LOGDrakon/Aurora/Docs/DT-AURORA-MEM-001.docx

# Document Technique Aurora — Structure Mémoire Flash

## DT-AURORA-MEM-001 — Révision B

Projet : Aurora — Verrine LED Industrielle Intelligente
Objet : Définition de la structure de données en mémoire Flash
Plateforme : STM32G0B1 — Flash interne
Date : 2025-01-15
Statut : Draft

## Table des matières

1. Introduction (https://mammouth.ai/app/a/130160/c/9894304)
2. Principes de conception (https://mammouth.ai/app/a/130160/c/9894304)
3. Cartographie mémoire (https://mammouth.ai/app/a/130160/c/9894304)
4. Header de configuration (https://mammouth.ai/app/a/130160/c/9894304)
5. Structure TLV générique (https://mammouth.ai/app/a/130160/c/9894304)
6. Bloc LEDS — 0x01 (https://mammouth.ai/app/a/130160/c/9894304)
7. Bloc SCÈNES — 0x02 (https://mammouth.ai/app/a/130160/c/9894304)
8. Bloc ENTRÉES — 0x03 (https://mammouth.ai/app/a/130160/c/9894304)
9. Bloc SYSTÈME — 0x04 (https://mammouth.ai/app/a/130160/c/9894304)
10. Bilan mémoire (https://mammouth.ai/app/a/130160/c/9894304)
11. Parser firmware (https://mammouth.ai/app/a/130160/c/9894304)
12. Intégrité et écriture Flash (https://mammouth.ai/app/a/130160/c/9894304)
13. Évolutivité (https://mammouth.ai/app/a/130160/c/9894304)
14. Annexes (https://mammouth.ai/app/a/130160/c/9894304)

## 1. Introduction

### 1.1 Objectif du document

Ce document définit le format binaire utilisé pour stocker la configuration complète d'un module Aurora en mémoire Flash interne du STM32G0B1. Cette structure est lue au démarrage par le firmware, modifiable via le bus de communication LINK, et éditable via l'application PC Aurora-LINK.

### 1.2 Périmètre

La configuration couvre :

- La définition matérielle de la sortie LED (2 LEDs pilotées en tandem)
- Les scènes d'éclairage prédéfinies (jusqu'à 16)
- Les patterns d'animation personnalisés (jusqu'à 8)
- Le mapping des entrées logiques (10 entrées)
- Les paramètres système (démarrage, diagnostics)

### 1.3 Hypothèse fondamentale

Les deux LEDs du module Aurora fonctionnent toujours ensemble, de manière synchrone. Il n'existe aucun mode permettant de les piloter indépendamment. Toute la configuration décrit donc un unique canal lumineux alimentant les deux LEDs simultanément.

### 1.4 Contraintes

Contrainte | Valeur
Taille page Flash STM32G0B1 | 2048 bytes
Endianness | Little-endian
Alignement | Structures packées (__attribute__((packed)))
Allocation dynamique | Interdite
Durée de vie Flash | 10 000 cycles d'écriture

## 2. Principes de conception

### 2.1 Format TLV (Type-Length-Value)

Toute la zone de données est organisée en blocs TLV contigus. Chaque bloc possède un identifiant de type, une longueur de payload, et les données associées. Ce format permet :

- Le parsing séquentiel sans table d'index
- L'ignorance des blocs inconnus pour la compatibilité ascendante
- L'ajout de nouveaux blocs sans modifier le parser existant

### 2.2 Pas d'allocation dynamique

Le parser lit la Flash en place (mapping direct par pointeurs). Les structures de travail en RAM sont de taille fixe, dimensionnées pour les maximums définis dans ce document.

### 2.3 Intégrité

Un CRC32 en fin de page garantit la validité de l'ensemble. Si le CRC est invalide ou le magic absent, le firmware démarre en mode par défaut.

## 3. Cartographie mémoire

Adresse | Contenu | Taille
0x000 0x010 0x7FC | Header de configuration Bloc LEDS (TLV) Bloc SCÈNES (TLV) Bloc ENTRÉES (TLV) Bloc SYSTÈME (TLV) … Padding (0xFF) CRC32 | 16 bytes variable variable variable variable variable 4 bytes
| TOTAL PAGE | 2048 bytes

Les blocs TLV se succèdent sans espacement. L'espace restant entre le dernier bloc et le CRC32 est rempli de 0xFF (état natif de la Flash effacée).

## 4. Header de configuration

### 4.1 Structure

typedef struct __attribute__((packed)) {

uint32_t magic; // Identifiant fixe

uint8_t version; // Version du format

uint8_t num_blocs; // Nombre de blocs TLV présents

uint16_t total_len; // Taille totale des données TLV (bytes)

uint32_t write_count; // Compteur d'écritures

uint32_t reserved; // Réservé (0xFFFFFFFF)

} aurora_header_t;

### 4.2 Détail des champs

Champ | Offset | Taille | Valeur | Description
magic | 0x00 | 4 | 0x41555241 | Signature ASCII "AURA"
version | 0x04 | 1 | 0x01 | Version du format de structure
num_blocs | 0x05 | 1 | 1–255 | Nombre de blocs TLV dans la page
total_len | 0x06 | 2 | 0–2028 | Taille cumulée de tous les blocs TLV
write_count | 0x08 | 4 | 0–n | Incrémenté à chaque écriture
reserved | 0x0C | 4 | 0xFFFFFFFF | Réservé pour usage futur

### 4.3 Taille

16 bytes fixes.

## 5. Structure TLV générique

### 5.1 En-tête de bloc

typedef struct __attribute__((packed)) {

uint8_t type; // Identifiant du bloc

uint8_t flags; // Drapeaux (réservé, mis à 0x00)

uint16_t length; // Taille du payload en bytes

uint8_t data[]; // Payload (flexible array member)

} aurora_bloc_t;

### 5.2 Table des types

Type ID | Nom | Description | Requis
0x01 | BLOC_LEDS | Configuration matérielle de la sortie LED | Oui
0x02 | BLOC_SCENES | Définition des scènes et patterns | Oui
0x03 | BLOC_INPUTS | Mapping des entrées logiques | Oui
0x04 | BLOC_SYSTEM | Paramètres système | Oui
0x05–0xEF | — | Réservés pour extensions futures | —
0xF0–0xFF | — | Réservés pour usage constructeur | —

### 5.3 Taille de l'en-tête TLV

4 bytes fixes + payload variable.

### 5.4 Règle de parsing

Le parser avance de sizeof(aurora_bloc_t) + bloc->length bytes à chaque itération. Un bloc de type inconnu est ignoré silencieusement (skip par la longueur).

## 6. Bloc LEDS — 0x01

### 6.1 Description

Ce bloc définit la configuration matérielle du canal LED unique. Les deux LEDs physiques sont pilotées de manière identique et synchrone. Ce bloc ne décrit pas l'état lumineux (c'est le rôle des scènes) mais les limites physiques du canal.

### 6.2 Structure

typedef struct __attribute__((packed)) {

uint8_t max_pwm; // Limitation PWM max (0–255 → 0–100%)

uint16_t soft_start_ms; // Durée de la rampe de démarrage

uint8_t reserved; // Réservé (0xFF)

} aurora_led_cfg_t;

### 6.3 Détail des champs

Champ | Taille | Plage | Description
max_pwm | 1 | 0–255 | Plafond PWM appliqué aux deux LEDs (protection thermique / optique)
soft_start_ms | 2 | 0–65535 | Rampe progressive au démarrage en ms
reserved | 1 | 0xFF | Réservé

### 6.4 Taille du bloc

- En-tête TLV : 4 bytes
- Payload : 4 bytes
- Total : 8 bytes

## 7. Bloc SCÈNES — 0x02

### 7.1 Description

Une scène est un état complet et statique du canal lumineux (les deux LEDs simultanément). Le module supporte jusqu'à 16 scènes. Une scène est activée soit par une entrée logique, soit par commande LINK, soit automatiquement au démarrage.

### 7.2 Structure d'état LED

typedef struct __attribute__((packed)) {

uint8_t mode; // Mode d'animation

uint8_t brightness; // Luminosité cible (0–255)

uint16_t t_on_ms; // Durée de la phase ON

uint16_t t_off_ms; // Durée de la phase OFF

uint8_t repeat; // Nombre de répétitions (0 = infini)

uint8_t fade_time; // Temps de fondu (unité : 10ms, 0 = instantané)

} aurora_led_state_t;

### 7.3 Modes LED

typedef enum {

LED_MODE_OFF = 0x00, // LEDs éteintes

LED_MODE_STATIC = 0x01, // Allumage fixe

LED_MODE_BLINK = 0x02, // Clignotement ON/OFF

LED_MODE_FADE = 0x03, // Respiration (fondu entrant/sortant)

LED_MODE_BURST = 0x04, // N flashs rapides + pause

LED_MODE_DOUBLE = 0x05, // Double flash aéronautique

LED_MODE_PATTERN = 0x06, // Pattern personnalisé

} aurora_led_mode_t;

### 7.4 Détail des modes

Mode | brightness | t_on_ms | t_off_ms | repeat | fade_time
OFF | ignoré | ignoré | ignoré | ignoré | ignoré
STATIC | niveau fixe | ignoré | ignoré | ignoré | rampe allumage
BLINK | niveau ON | durée ON | durée OFF | 0 = infini | transition
FADE | niveau max | durée montée | durée descente | 0 = infini | ignoré (implicite)
BURST | niveau flash | durée flash | pause entre bursts | nb flashs par burst | ignoré
DOUBLE | niveau flash | durée flash | pause inter-flash | ignoré (toujours 2) | pause post-double
PATTERN | ignoré | ignoré | ignoré | ignoré | index pattern

### 7.5 Structure de scène

typedef struct __attribute__((packed)) {

uint8_t scene_id; // Identifiant : 0x00–0x0F

uint8_t flags; // Drapeaux

aurora_led_state_t state; // État du canal lumineux

} aurora_scene_t;

### 7.6 Drapeaux de scène

Bit | Nom | Description
0 | SCENE_FLAG_AUTOSTART | Charger cette scène automatiquement au démarrage
1–7 | — | Réservés (mis à 0)

### 7.7 Patterns personnalisés

Lorsqu'un état LED utilise LED_MODE_PATTERN, le champ fade_time contient l'index d'un pattern stocké à la suite des scènes dans le même bloc.

typedef struct __attribute__((packed)) {

uint8_t brightness; // Niveau de luminosité cible

uint8_t duration; // Durée de ce pas (unité : 10ms, max 2.55s)

} aurora_pattern_step_t;

typedef struct __attribute__((packed)) {

uint8_t pattern_id; // Identifiant : 0x00–0x07

uint8_t length; // Nombre de pas (max 16)

aurora_pattern_step_t steps[]; // Tableau de pas

} aurora_pattern_t;

### 7.8 Organisation interne du bloc SCÈNES

### En-tête TLV (4 bytes)

aurora_scene_t #0 (10 B)

aurora_scene_t #1 (10 B)

aurora_scene_t #15 (10 B)

aurora_pattern_t #0

aurora_pattern_t #1

aurora_pattern_t #7

### 7.9 Exemple concret — scène alarme

Canal lumineux : clignotement à 100%, 200ms ON / 800ms OFF, infini

Octets (hex) :

Scène : 00 00 → scene_id=0, flags=0

État : 02 FF 00C8 0320 00 00 → BLINK, 255, 200ms, 800ms, infini, pas de fondu

### 7.10 Taille du bloc

- En-tête TLV : 4 bytes
- Scènes : 16 × 10 = 160 bytes
- Patterns : 8 × (2 + 16 × 2) = 272 bytes
- Total max : 436 bytes

Seules les scènes et patterns effectivement utilisés doivent être stockés. Le nombre est déterminé dynamiquement par la longueur du bloc.

## 8. Bloc ENTRÉES — 0x03

### 8.1 Description

Chaque entrée logique (10 entrées disponibles) est associée à une règle composée d'un déclencheur (trigger) et d'une action.

### 8.2 Structure

typedef struct __attribute__((packed)) {

uint8_t input_id; // Index d'entrée : 0–9

uint8_t trigger; // Type de déclencheur

uint8_t action; // Action à exécuter

uint8_t target; // Cible de l'action (scene_id, etc.)

uint16_t param; // Paramètre contextuel

uint16_t debounce_ms; // Durée d'anti-rebond

} aurora_input_cfg_t;

### 8.3 Déclencheurs

typedef enum {

TRIG_RISING = 0x00, // Front montant

TRIG_FALLING = 0x01, // Front descendant

TRIG_HIGH = 0x02, // Niveau haut maintenu

TRIG_LOW = 0x03, // Niveau bas maintenu

TRIG_DOUBLE_TAP = 0x04, // Double impulsion (param = fenêtre ms)

TRIG_LONG_PRESS = 0x05, // Appui long (param = seuil ms)

TRIG_PULSE = 0x06, // Impulsion calibrée (param = durée attendue ms)

} aurora_trigger_t;

### 8.4 Actions

typedef enum {

ACT_LOAD_SCENE = 0x00, // Charger scène (target = scene_id)

ACT_SET_BRIGHT = 0x01, // Fixer luminosité (param.lo = brightness)

ACT_TOGGLE = 0x02, // Basculer ON/OFF

ACT_ALL_OFF = 0x03, // Tout éteindre

ACT_DIM_UP = 0x04, // Augmenter luminosité (param = pas)

ACT_DIM_DOWN = 0x05, // Diminuer luminosité (param = pas)

ACT_LOCK = 0x06, // Verrouiller toutes les autres entrées

ACT_UNLOCK = 0x07, // Déverrouiller les entrées

ACT_IDENTIFY = 0x08, // Lancer la séquence d'identification visuelle

} aurora_action_t;

### 8.5 Matrice trigger × action — exemples

Cas d'usage | Entrée | Trigger | Action | Target | Param
Alarme incendie | E0 | TRIG_HIGH | ACT_LOAD_SCENE | 1 | —
Bouton poussoir | E1 | TRIG_RISING | ACT_TOGGLE | — | —
Variateur + | E2 | TRIG_RISING | ACT_DIM_UP | — | 25
Appui long reset | E3 | TRIG_LONG_PRESS | ACT_ALL_OFF | — | 3000
Double tap ident | E4 | TRIG_DOUBLE_TAP | ACT_IDENTIFY | — | 500

### 8.6 Anti-rebond

Le champ debounce_ms définit la durée minimale pendant laquelle l'entrée doit rester stable avant validation du changement d'état. Plage recommandée : 10–50ms pour boutons mécaniques, 1–5ms pour signaux logiques propres.

### 8.7 Taille du bloc

- En-tête TLV : 4 bytes
- Entrées : 10 × 8 = 80 bytes
- Total : 84 bytes

## 9. Bloc SYSTÈME — 0x04

### 9.1 Description

Paramètres globaux du module : comportement au démarrage et diagnostics.

### 9.2 Structure

typedef struct __attribute__((packed)) {

uint8_t boot_scene; // Scène chargée au démarrage (0xFF = aucune)

uint8_t temp_derating; // Seuil de derating thermique (°C, 0 = désactivé)

uint16_t hours_counter; // Compteur horaire cumulé (heures)

uint32_t reserved; // Réservé (0xFFFFFFFF)

} aurora_system_cfg_t;

### 9.3 Détail des champs

Champ | Taille | Plage | Description
boot_scene | 1 | 0x00–0x0F, 0xFF | Scène auto au power-on. 0xFF = pas de scène auto
temp_derating | 1 | 0–150 | Température en °C au-delà de laquelle le firmware réduit la puissance. 0 = fonction désactivée
hours_counter | 2 | 0–65535 | Compteur horaire incrémenté par le firmware. Sauvegardé périodiquement
reserved | 4 | 0xFFFFFFFF | Réservé pour usage futur

### 9.4 Taille du bloc

- En-tête TLV : 4 bytes
- Payload : 8 bytes
- Total : 12 bytes

## 10. Bilan mémoire

### 10.1 Synthèse

Élément | Taille | Remarque
Header | 16 bytes | Fixe
Bloc LEDS | 8 bytes | Canal unique
Bloc SCÈNES | 436 bytes max | 16 scènes + 8 patterns
Bloc ENTRÉES | 84 bytes | 10 entrées
Bloc SYSTÈME | 12 bytes | Fixe
CRC32 | 4 bytes | Fin de page
TOTAL | ≈ 560 bytes
Disponible | 2048 bytes
Marge | ≈ 1488 bytes (73%)

### 10.2 Répartition visuelle

███████░░░░░░░░░░░░░░ 27% utilisé (560 / 2048)

Header ██

LEDs ░

Scènes ████████████████████████

Entrées ████

Système █

CRC ░

Libre ██████████████████████████████████████████████

La marge restante permet l'ajout de plusieurs blocs supplémentaires sans nécessiter une seconde page Flash.

## 11. Parser firmware

### 11.1 Algorithme de chargement

void aurora_load_config(const uint8_t *flash_base)

{

const aurora_header_t *hdr = (aurora_header_t *)flash_base;

/* Vérification du magic */

if (hdr->magic != 0x41555241) {

aurora_load_defaults();

return;

}

/* Vérification de la version */

if (hdr->version > AURORA_FORMAT_VERSION) {

aurora_load_defaults();

return;

}

/* Vérification du CRC32 */

uint32_t computed = crc32(flash_base,

sizeof(aurora_header_t) + hdr->total_len);

uint32_t stored = *(uint32_t *)(flash_base

+ sizeof(aurora_header_t) + hdr->total_len);

if (computed != stored) {

aurora_load_defaults();

return;

}

/* Parcours séquentiel des blocs TLV */

const uint8_t *ptr = flash_base + sizeof(aurora_header_t);

const uint8_t *end = ptr + hdr->total_len;

while (ptr < end) {

const aurora_bloc_t *bloc = (aurora_bloc_t *)ptr;

switch (bloc->type) {

case 0x01: parse_leds(bloc->data, bloc->length); break;

case 0x02: parse_scenes(bloc->data, bloc->length); break;

case 0x03: parse_inputs(bloc->data, bloc->length); break;

case 0x04: parse_system(bloc->data, bloc->length); break;

default: break; /* Bloc inconnu → ignoré */

}

ptr += sizeof(aurora_bloc_t) + bloc->length;

}

}

### 11.2 Configuration par défaut

Si le header est invalide ou le CRC incorrect, le firmware charge une configuration minimale codée en dur :

Paramètre | Valeur par défaut
Canal LED | Éteint
Scènes | Aucune
Entrées | Aucun mapping
Boot scene | 0xFF (aucune)

## 12. Intégrité et écriture Flash

### 12.1 Procédure d'écriture

1. Préparer le buffer complet en RAM (2048 bytes)
2. Incrémenter write_count
3. Calculer le CRC32 sur header + blocs TLV
4. Placer le CRC32 à l'offset sizeof(header) + total_len
5. Effacer la page Flash cible
6. Écrire le buffer complet par double-words (64 bits)
7. Relire et comparer (vérification d'écriture)

### 12.2 Protection contre les coupures

L'écriture Flash n'est pas atomique. En cas de coupure pendant l'écriture :

- Le CRC32 sera invalide à la relecture
- Le firmware chargera la configuration par défaut
- Aucune corruption partielle ne sera appliquée

### 12.3 Double page (optionnel, V2)

Pour une protection renforcée, un mécanisme de double page (ping-pong) peut être implémenté :

- Page A et Page B en alternance
- Le write_count le plus élevé avec CRC valide est la config active
- En cas de corruption d'une page, l'autre reste disponible

### 12.4 Usure Flash

Le STM32G0B1 garantit 10 000 cycles d'écriture par page. Le champ write_count permet de surveiller l'usure. Pour une configuration modifiée une fois par jour, la durée de vie dépasse 27 ans.

## 13. Évolutivité

### 13.1 Ajout d'un nouveau bloc

L'architecture TLV permet d'ajouter des blocs sans modifier le parser existant. Procédure :

1. Attribuer un type ID dans la plage 0x05–0xEF
2. Définir la structure du payload
3. Ajouter le case correspondant dans le parser
4. Les firmwares antérieurs ignoreront automatiquement le nouveau bloc

### 13.2 Blocs envisagés pour les futures versions

Type ID | Nom | Description
0x05 | BLOC_SEQUENCES | Enchaînement temporisé de scènes
0x06 | BLOC_CALENDAR | Programmation horaire
0x07 | BLOC_ANALOG | Configuration des entrées analogiques
0x08 | BLOC_LINK | Paramètres de communication LINK
0x09 | BLOC_USERDATA | Données utilisateur libres

### 13.3 Versioning

Le champ version du header permet de gérer les évolutions majeures du format. Règle de compatibilité :

- Même version : compatibilité totale
- Version supérieure : le firmware refuse de charger et utilise les défauts
- Version inférieure : le firmware peut charger avec migration (si implémenté)

## 14. Annexes

### 14.1 Tableau récapitulatif des structures

Structure | Taille | Usage
aurora_header_t | 16 bytes | En-tête de page
aurora_bloc_t | 4 bytes + payload | Enveloppe TLV
aurora_led_cfg_t | 4 bytes | Config matérielle canal LED
aurora_led_state_t | 8 bytes | État du canal dans une scène
aurora_scene_t | 10 bytes | Scène complète
aurora_pattern_step_t | 2 bytes | Pas d'animation
aurora_pattern_t | 2 bytes + steps | Pattern complet
aurora_input_cfg_t | 8 bytes | Règle d'entrée
aurora_system_cfg_t | 8 bytes | Paramètres système

### 14.2 Dump hexadécimal — exemple complet

Offset Données (hex) Signification

──────── ──────────────────────────────────────────────── ──────────────

0x0000 41 55 52 41 01 04 34 02 01 00 00 00 FF FF FF FF Header AURA v1

0x0010 01 00 04 00 FF 00 64 FF Bloc LEDS

0x0018 02 00 0C 00 00 00 02 FF C8 00 20 03 00 00 Bloc SCÈNES (1)

0x0026 03 00 08 00 00 00 00 01 00 00 14 00 Bloc ENTRÉES (1)

0x0032 04 00 08 00 00 00 00 00 FF FF FF FF Bloc SYSTÈME

0x07FC XX XX XX XX CRC32

### 14.3 Références

Document | Description
RM0444 | Reference Manual STM32G0B1
DT-AURORA-EE-001 | Schéma électronique Aurora
DT-AURORA-FW-001 | Architecture firmware Aurora
DT-AURORA-LINK-001 | Protocole de communication LINK

### Historique des révisions

Révision | Date | Modifications
A | 2025-01-15 | Création initiale
B | 2025-01-15 | Canal LED unique (2 LEDs synchrones). Retrait des paramètres LINK du bloc système (déplacés vers futur BLOC_LINK)

Fin du document DT-AURORA-MEM-001 Rév. B
