LOGDrakon/Aurora/PCB/Aurora/Aurora.kicad_pcb

## KiCad design PCB/Aurora/Aurora.kicad_pcb (2026-03-30)

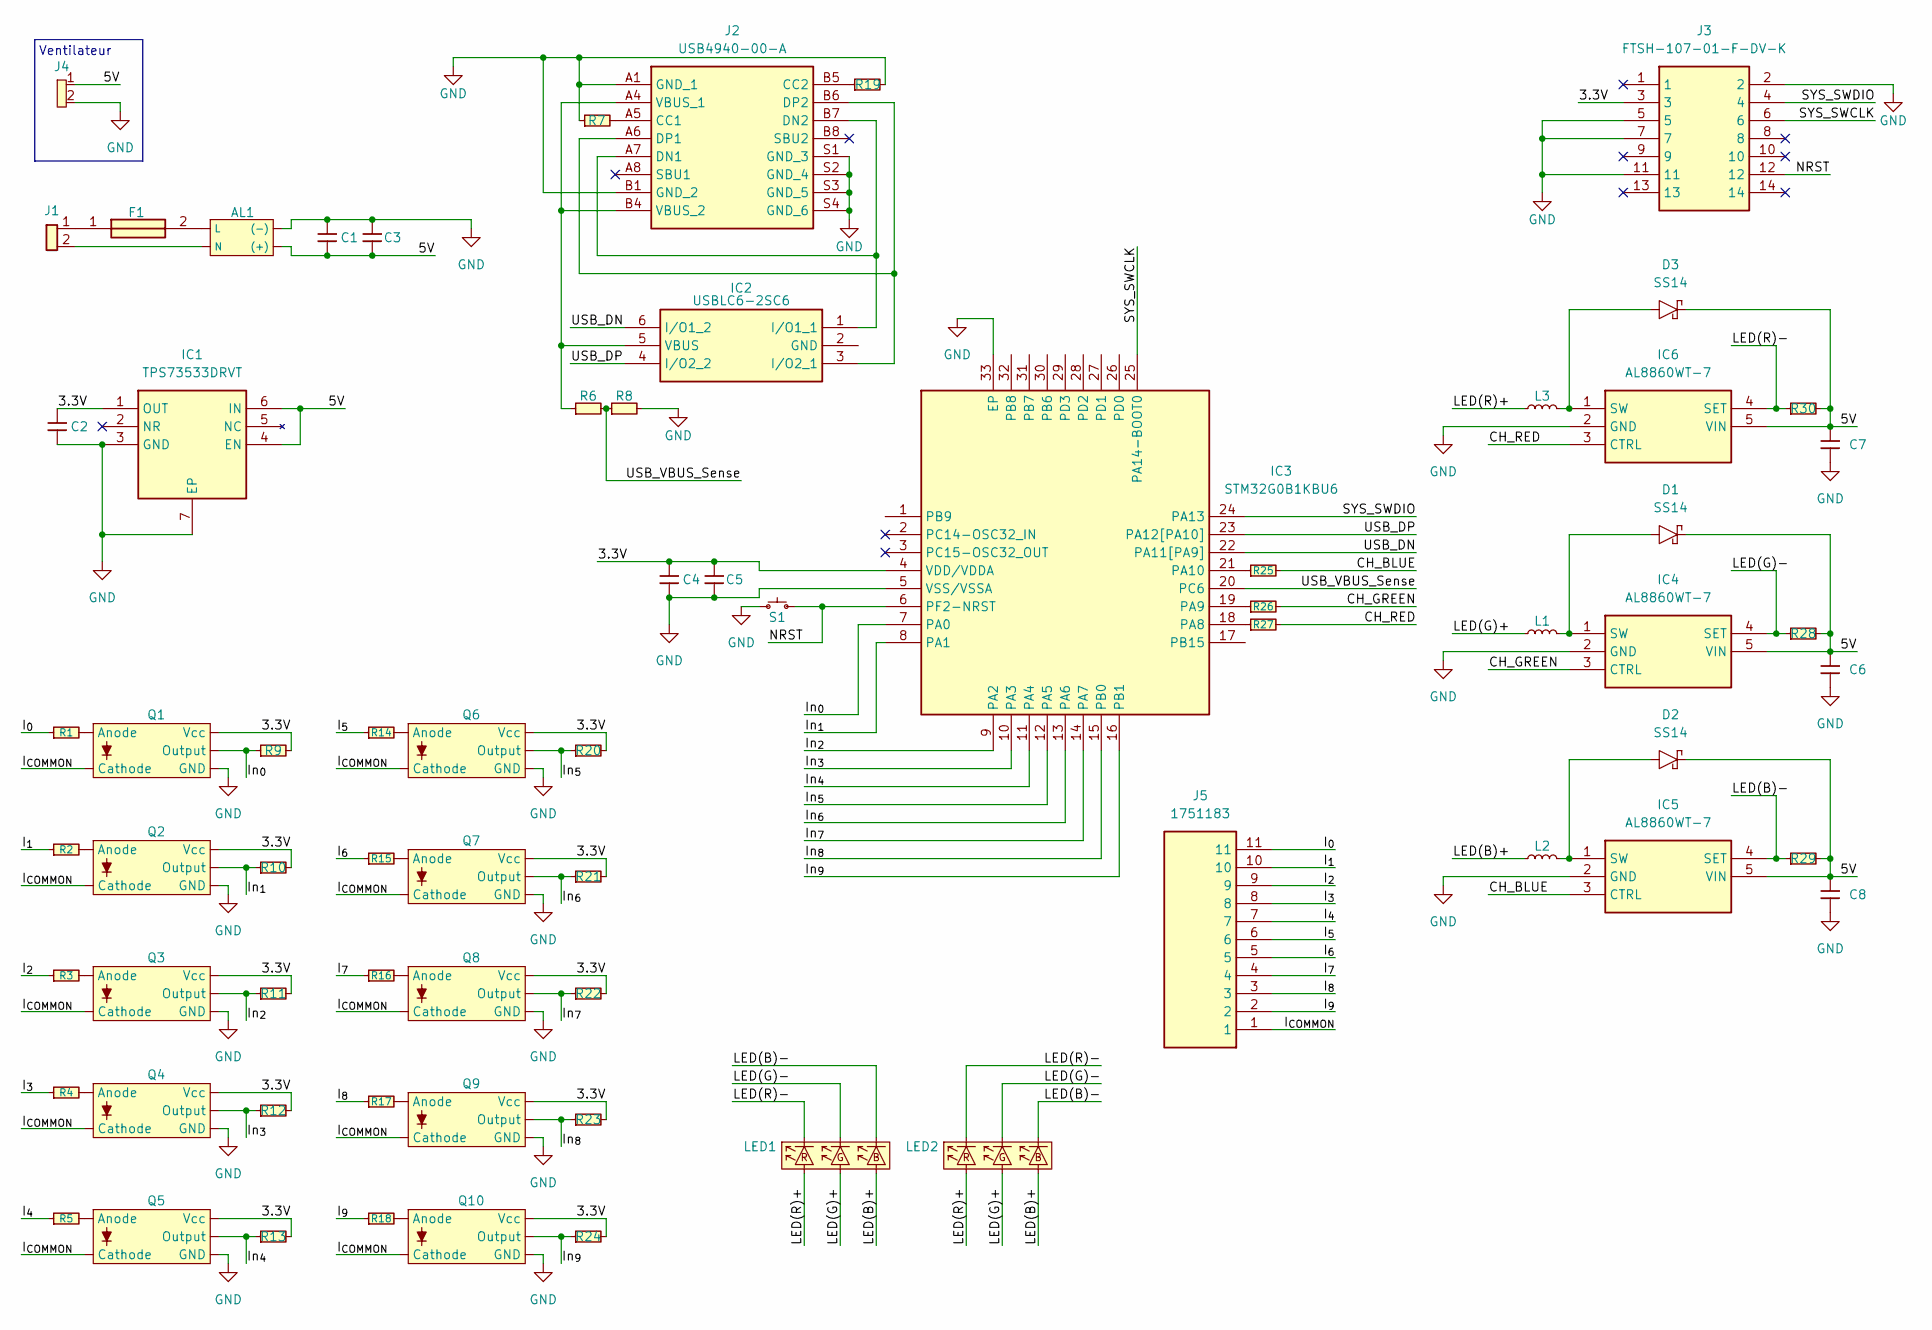
[picture p1: schematic Aurora.kicad_sch]

Parts:
AL1: PSK-10E-5; Parts Reference PSK-10E-5; Mouser No 490-PSK-10E-5
C1, C2, C4: GXT21BR71A475KE13L; CAPC2012X140N; Manufacturer_Part_Number GXT21BR71A475KE13L
C3: 100nF; C_0402_1005Metric; Parts Reference AC0402KRX7R7BB104
C5: 100nF; C_0402_1005Metric
C6, C7, C8: CGA4J1X7R0J106K125AC; CGA4J2NP01H223J125AA; Mouser Part Number 810-CGA4J1X7R0J106K
D1, D2, D3: SS14; DIOM5227X270N; Mouser Part Number 512-SS14
F1: 3403.0166.24; 3403016624; Mouser Part Number 693-3403.0166.24
IC1: TPS73533DRVT; SON65P200X200X80-7N; Mouser Part Number 595-TPS73533DRVT
IC2: USBLC6-2SC6; SOT95P280X145-6N; Mouser Part Number 511-USBLC6-2SC6
IC3: STM32G0B1KBU6; QFN-32-1EP_5x5mm_P0.5mm_EP3.45x3.45mm
IC4, IC5, IC6: AL8860WT-7; SOT95P280X100-5N; Mouser Part Number 621-AL8860WT-7
J1: 1190297; Mouser Part Number 651-1190297
J2: USB4940-00-A; USB494000A; Manufacturer_Part_Number USB4940-00-A
J3: FTSH-107-01-F-DV-K; FTSH-107-XX-YYY-DV-K; Mouser Part Number 200-FTSH10701FDVK
J4: 1190297; Pad_Connector_2; Mouser Part Number 651-1190297
J5: 1751183; Mouser Part Number 651-1751183
L1, L2, L3: PA4332.472NLT; PA4332472NLT; Mouser Part Number 673-PA4332472NLT
LED1, LED2: OT-3RGB-C30
Q1, Q2, Q3, Q4, Q5, Q6, Q7, Q8, Q9, Q10: TLP2303TPLE; Parts Reference TLP2303TPLE; Mouser No 757-TLP2303TPLE
R1, R2, R3, R4, R5, R14, R15, R16, R17, R18: 5.1R; RESC5025X120N; Mouser Part Number 279-35025K1FT
R6: MCT0603MC3302FP500; RESC1608X55N; Mouser Part Number 594-MCT0603MC3302FP5
R7, R19: CR0603-FX-5101ELF; RESC1608X55N; Mouser Part Number 652-CR0603FX-5101ELF
R8: ERJ-P08F8202V; ERJP08__1206_; Mouser Part Number 667-ERJ-P08F8202V
R9, R10, R11, R12, R13, R20, R21, R22, R23, R24: 3.3R; RESC1608X55N; Mouser Part Number 652-CR0603-FX3301ELF
R25, R26, R27: 100R; R_0603_1608Metric; Parts Reference SFR03EZPJ101; Mouser No 755-SFR03EZPJ101
R28, R29, R30: 0.16R; R_0603_1608Metric; Parts Reference RL0603FR-070R16L; Mouser No 603-RL0603FR-070R16L
S1: SPST; TS09-63-25-WT-160-SMT-TR; Parts Reference TS09-63-25-WT-160-SMT-TR; Mouser No 179-TS0925WT160SMTTR

Connections:
/3.3V: C2.1, C4.1, C5.1, IC1.1 (OUT), IC3.4 (VDD/VDDA), J3.3, Q1.6 (Vcc), Q2.6 (Vcc), Q3.6 (Vcc), Q4.6 (Vcc), Q5.6 (Vcc), Q6.6 (Vcc), Q7.6 (Vcc), Q8.6 (Vcc), Q9.6 (Vcc), Q10.6 (Vcc), R9.2, R10.2, R11.2, R12.2, R13.2, R20.2, R21.2, R22.2, R23.2, R24.2
/5V: AL1.4 ((+)), C1.2, C3.2, C6.1, C7.1, C8.1, D1.1, D2.1, D3.1, IC1.4 (EN), IC1.6 (IN), IC4.5 (VIN), IC5.5 (VIN), IC6.5 (VIN), J4.1, R28.2, R29.2, R30.2
/CH_BLUE: IC5.3 (CTRL), R25.2
/CH_GREEN: IC4.3 (CTRL), R26.2
/CH_RED: IC6.3 (CTRL), R27.2
/I_{0}: J5.11, R1.1
/I_{1}: J5.10, R2.1
/I_{2}: J5.9, R3.1
/I_{3}: J5.8, R4.1
/I_{4}: J5.7, R5.1
/I_{5}: J5.6, R14.1
/I_{6}: J5.5, R15.1
/I_{7}: J5.4, R16.1
/I_{8}: J5.3, R17.1
/I_{9}: J5.2, R18.1
/I_{COMMON}: J5.1, Q1.3 (Cathode), Q2.3 (Cathode), Q3.3 (Cathode), Q4.3 (Cathode), Q5.3 (Cathode), Q6.3 (Cathode), Q7.3 (Cathode), Q8.3 (Cathode), Q9.3 (Cathode), Q10.3 (Cathode)
/In_{0}: IC3.7 (PA0), Q1.5 (Output), R9.1
/In_{1}: IC3.8 (PA1), Q2.5 (Output), R10.1
/In_{2}: IC3.9 (PA2), Q3.5 (Output), R11.1
/In_{3}: IC3.10 (PA3), Q4.5 (Output), R12.1
/In_{4}: IC3.11 (PA4), Q5.5 (Output), R13.1
/In_{5}: IC3.12 (PA5), Q6.5 (Output), R20.1
/In_{6}: IC3.13 (PA6), Q7.5 (Output), R21.1
/In_{7}: IC3.14 (PA7), Q8.5 (Output), R22.1
/In_{8}: IC3.15 (PB0), Q9.5 (Output), R23.1
/In_{9}: IC3.16 (PB1), Q10.5 (Output), R24.1
/LED(B)+: L2.1, LED1.6, LED2.6
/LED(B)-: IC5.4 (SET), LED1.5, LED2.5, R29.1
/LED(G)+: L1.1, LED1.4, LED2.4
/LED(G)-: IC4.4 (SET), LED1.3, LED2.3, R28.1
/LED(R)+: L3.1, LED1.2, LED2.2
/LED(R)-: IC6.4 (SET), LED1.1, LED2.1, R30.1
/NRST: IC3.6 (PF2-NRST), J3.12, S1.2
/SYS_SWCLK: IC3.25 (PA14-BOOT0), J3.6
/SYS_SWDIO: IC3.24 (PA13), J3.4
/USB_DN: IC2.6 (I/O1_2), IC3.22 (PA11[PA9])
/USB_DP: IC2.4 (I/O2_2), IC3.23 (PA12[PA10])
/USB_VBUS_Sense: IC3.20 (PC6), R6.2, R8.1
GND: AL1.3 ((-)), C1.1, C2.2, C3.1, C4.2, C5.2, C6.2, C7.2, C8.2, IC1.3 (GND), IC1.7 (EP), IC3.5 (VSS/VSSA), IC3.33 (EP), IC4.2 (GND), IC5.2 (GND), IC6.2 (GND), J2.A1 (GND_1), J2.B1 (GND_2), J2.S1 (GND_3), J2.S2 (GND_4), J2.S3 (GND_5), J2.S4 (GND_6), J3.2, J3.5, J3.7, J3.11, J4.2, Q1.4 (GND), Q2.4 (GND), Q3.4 (GND), Q4.4 (GND), Q5.4 (GND), Q6.4 (GND), Q7.4 (GND), Q8.4 (GND), Q9.4 (GND), Q10.4 (GND), R7.1, R8.2, R19.2, S1.1
unnamed: AL1.1 (L), F1.2
unnamed: AL1.2 (N), J1.2, J1.4
unnamed: F1.1, J1.1, J1.3
unnamed: IC2.1 (I/O1_1), J2.A7 (DN1), J2.B7 (DN2)
unnamed: IC2.3 (I/O2_1), J2.A6 (DP1), J2.B6 (DP2)
unnamed: IC2.5 (VBUS), J2.A4 (VBUS_1), J2.B4 (VBUS_2), R6.1
unnamed: IC3.18 (PA8), R27.1
unnamed: IC3.19 (PA9), R26.1
unnamed: IC3.21 (PA10), R25.1
unnamed: D1.2, IC4.1 (SW), L1.2
unnamed: D2.2, IC5.1 (SW), L2.2
unnamed: D3.2, IC6.1 (SW), L3.2
unnamed: J2.A5 (CC1), R7.2
unnamed: J2.B5 (CC2), R19.1
unnamed: Q1.1 (Anode), R1.2
unnamed: Q2.1 (Anode), R2.2
unnamed: Q3.1 (Anode), R3.2
unnamed: Q4.1 (Anode), R4.2
unnamed: Q5.1 (Anode), R5.2
unnamed: Q6.1 (Anode), R14.2
unnamed: Q7.1 (Anode), R15.2
unnamed: Q8.1 (Anode), R16.2
unnamed: Q9.1 (Anode), R17.2
unnamed: Q10.1 (Anode), R18.2

Notes on the sheet:
Ventilateur

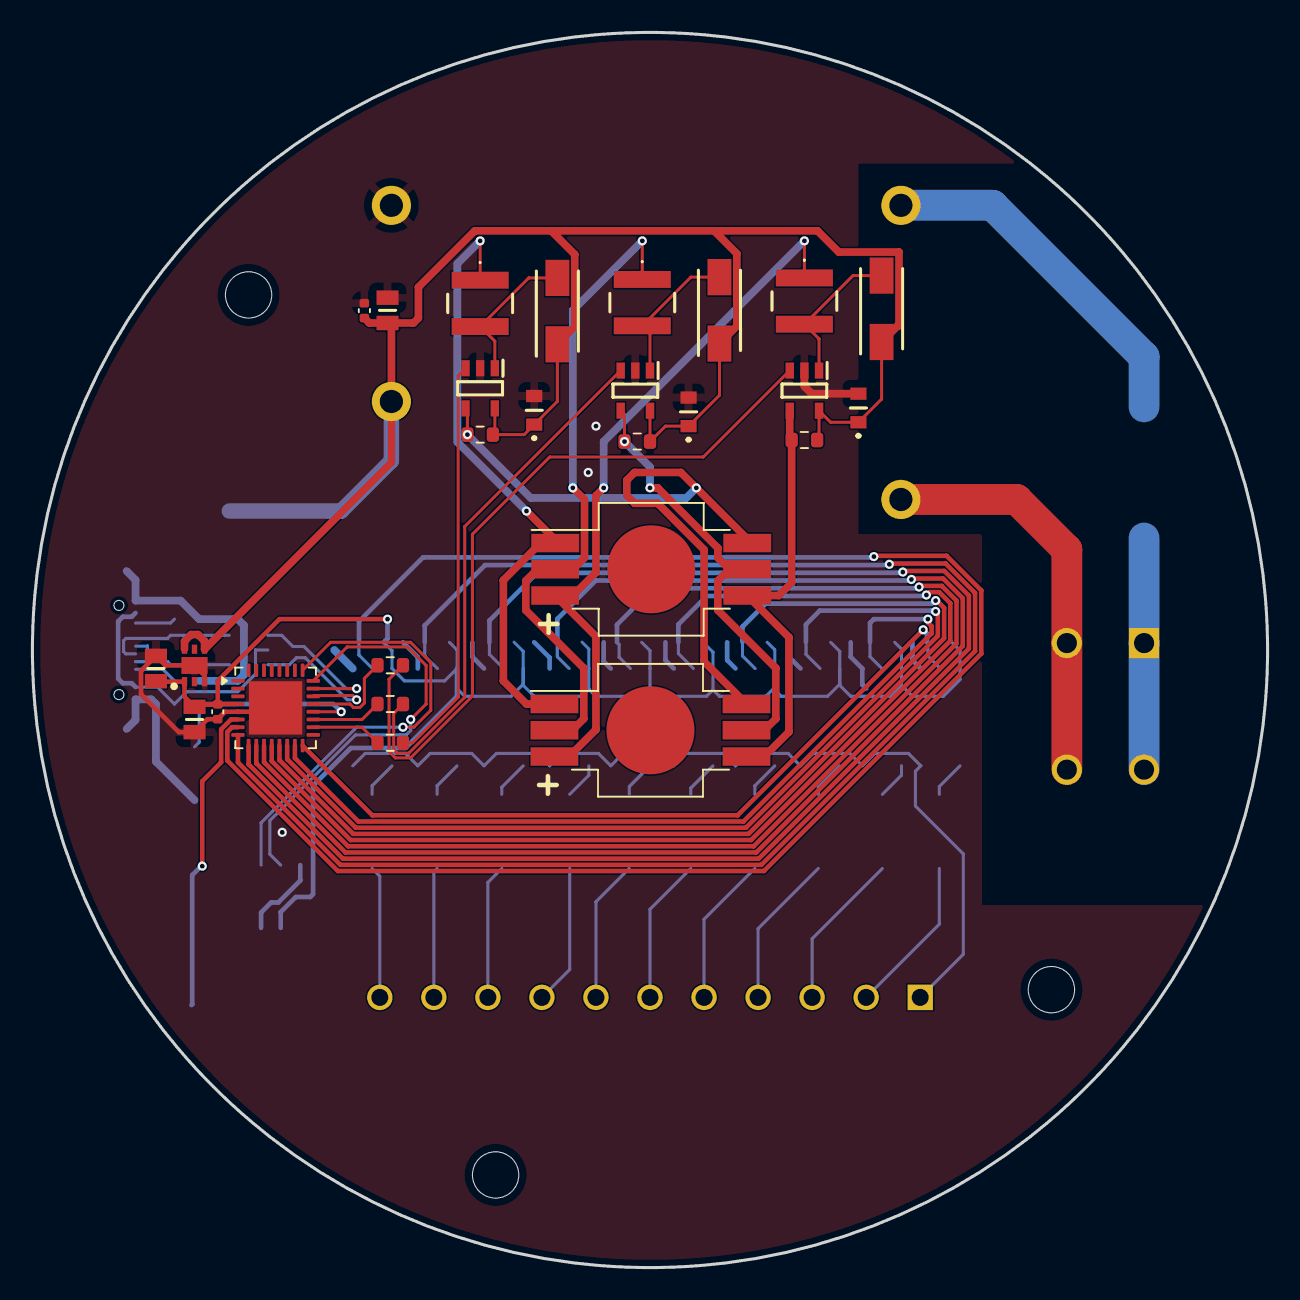
[picture p2: board Aurora.kicad_pcb from above]

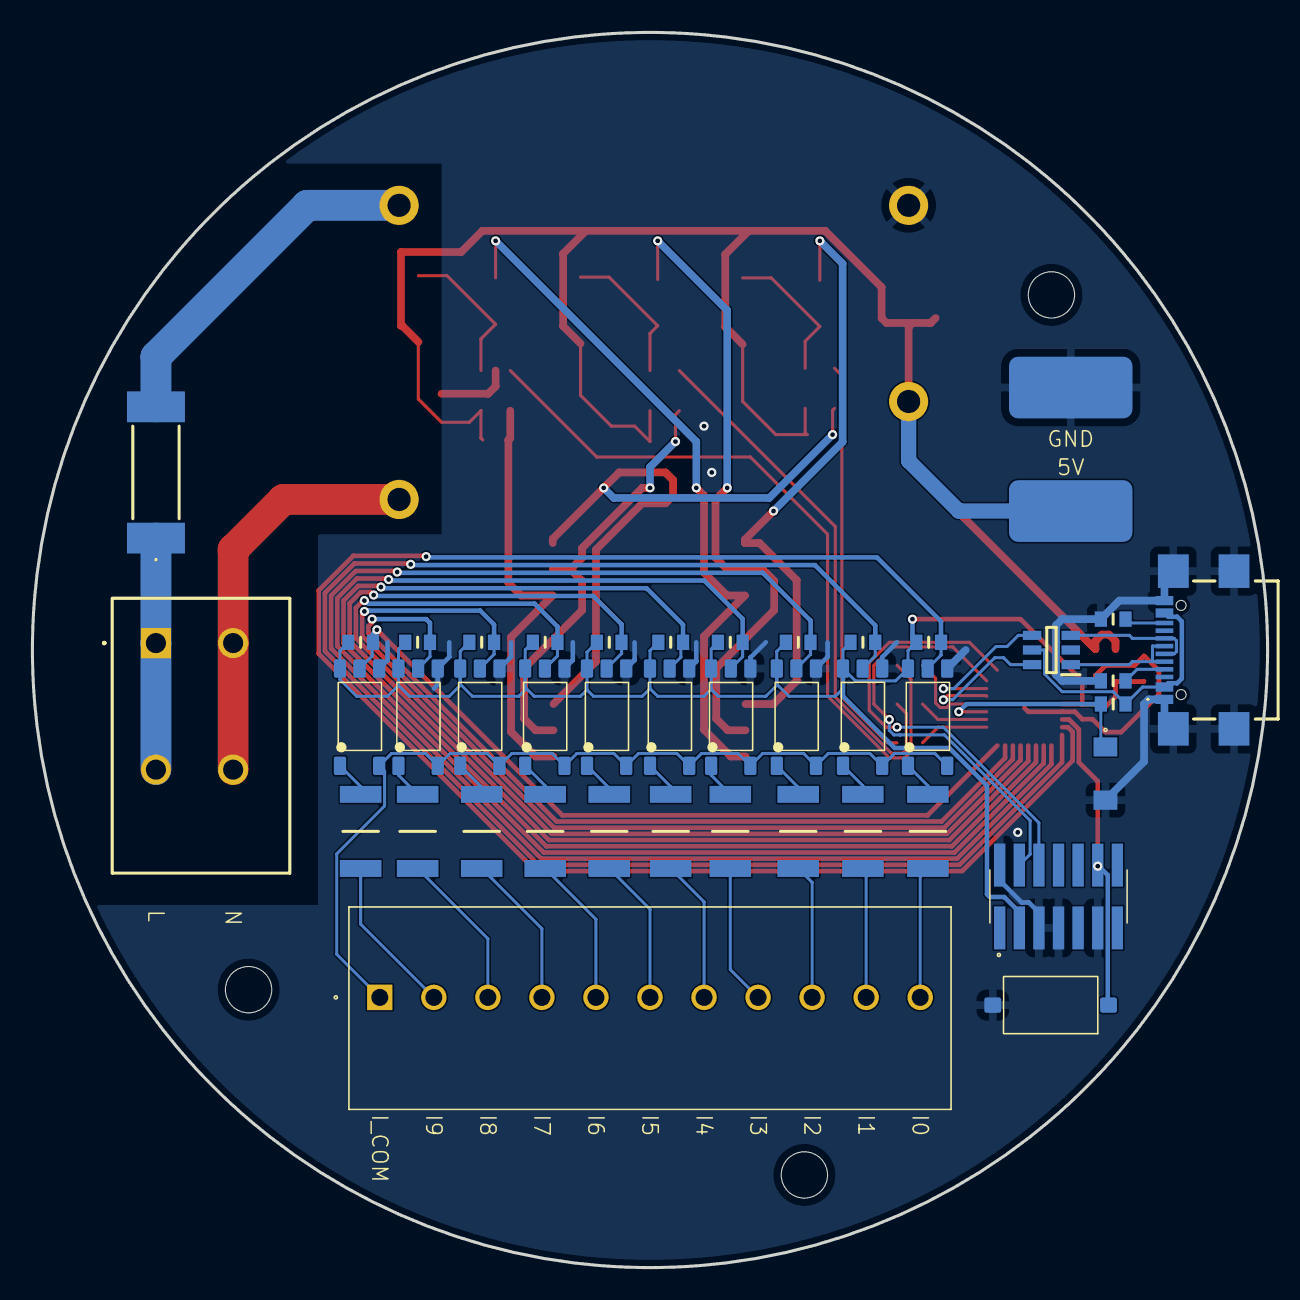
[picture p3: board Aurora.kicad_pcb from below]

Board: 2 copper layers, 80.0 x 80.0 mm, 70 parts (43 on the bottom side), 63 nets.
