LOGDrakon/Aurora/Programmes/Aurora-embd/Aurora-embd.ioc

Mcu.UserName=STM32G0B1KBUx
PA0.GPIO_Label=I0
PA0.Signal=GPIO_Input
PA1.GPIO_Label=I1
PA1.Signal=GPIO_Input
PA10.Signal=S_TIM1_CH3
PA13.Signal=SYS_SWDIO
PA14-BOOT0.Signal=SYS_SWCLK
PA2.GPIO_Label=I2
PA2.Signal=GPIO_Input
PA3.GPIO_Label=I3
PA3.Signal=GPIO_Input
PA4.GPIO_Label=I4
PA4.Signal=GPIO_Input
PA5.GPIO_Label=I5
PA5.Signal=GPIO_Input
PA6.GPIO_Label=I6
PA6.Signal=GPIO_Input
PA7.GPIO_Label=I7
PA7.Signal=GPIO_Input
PA8.Signal=S_TIM1_CH1
PA9.Signal=S_TIM1_CH2
PB0.GPIO_Label=I8
PB0.Signal=GPIO_Input
PB1.GPIO_Label=I9
PB1.Signal=GPIO_Input
PC6.GPIO_Label=VBUS_Sense
PC6.Signal=GPIO_Input
